tspui/rotary-printer/gerber/SmithBoard Rev B Schematic.PDF

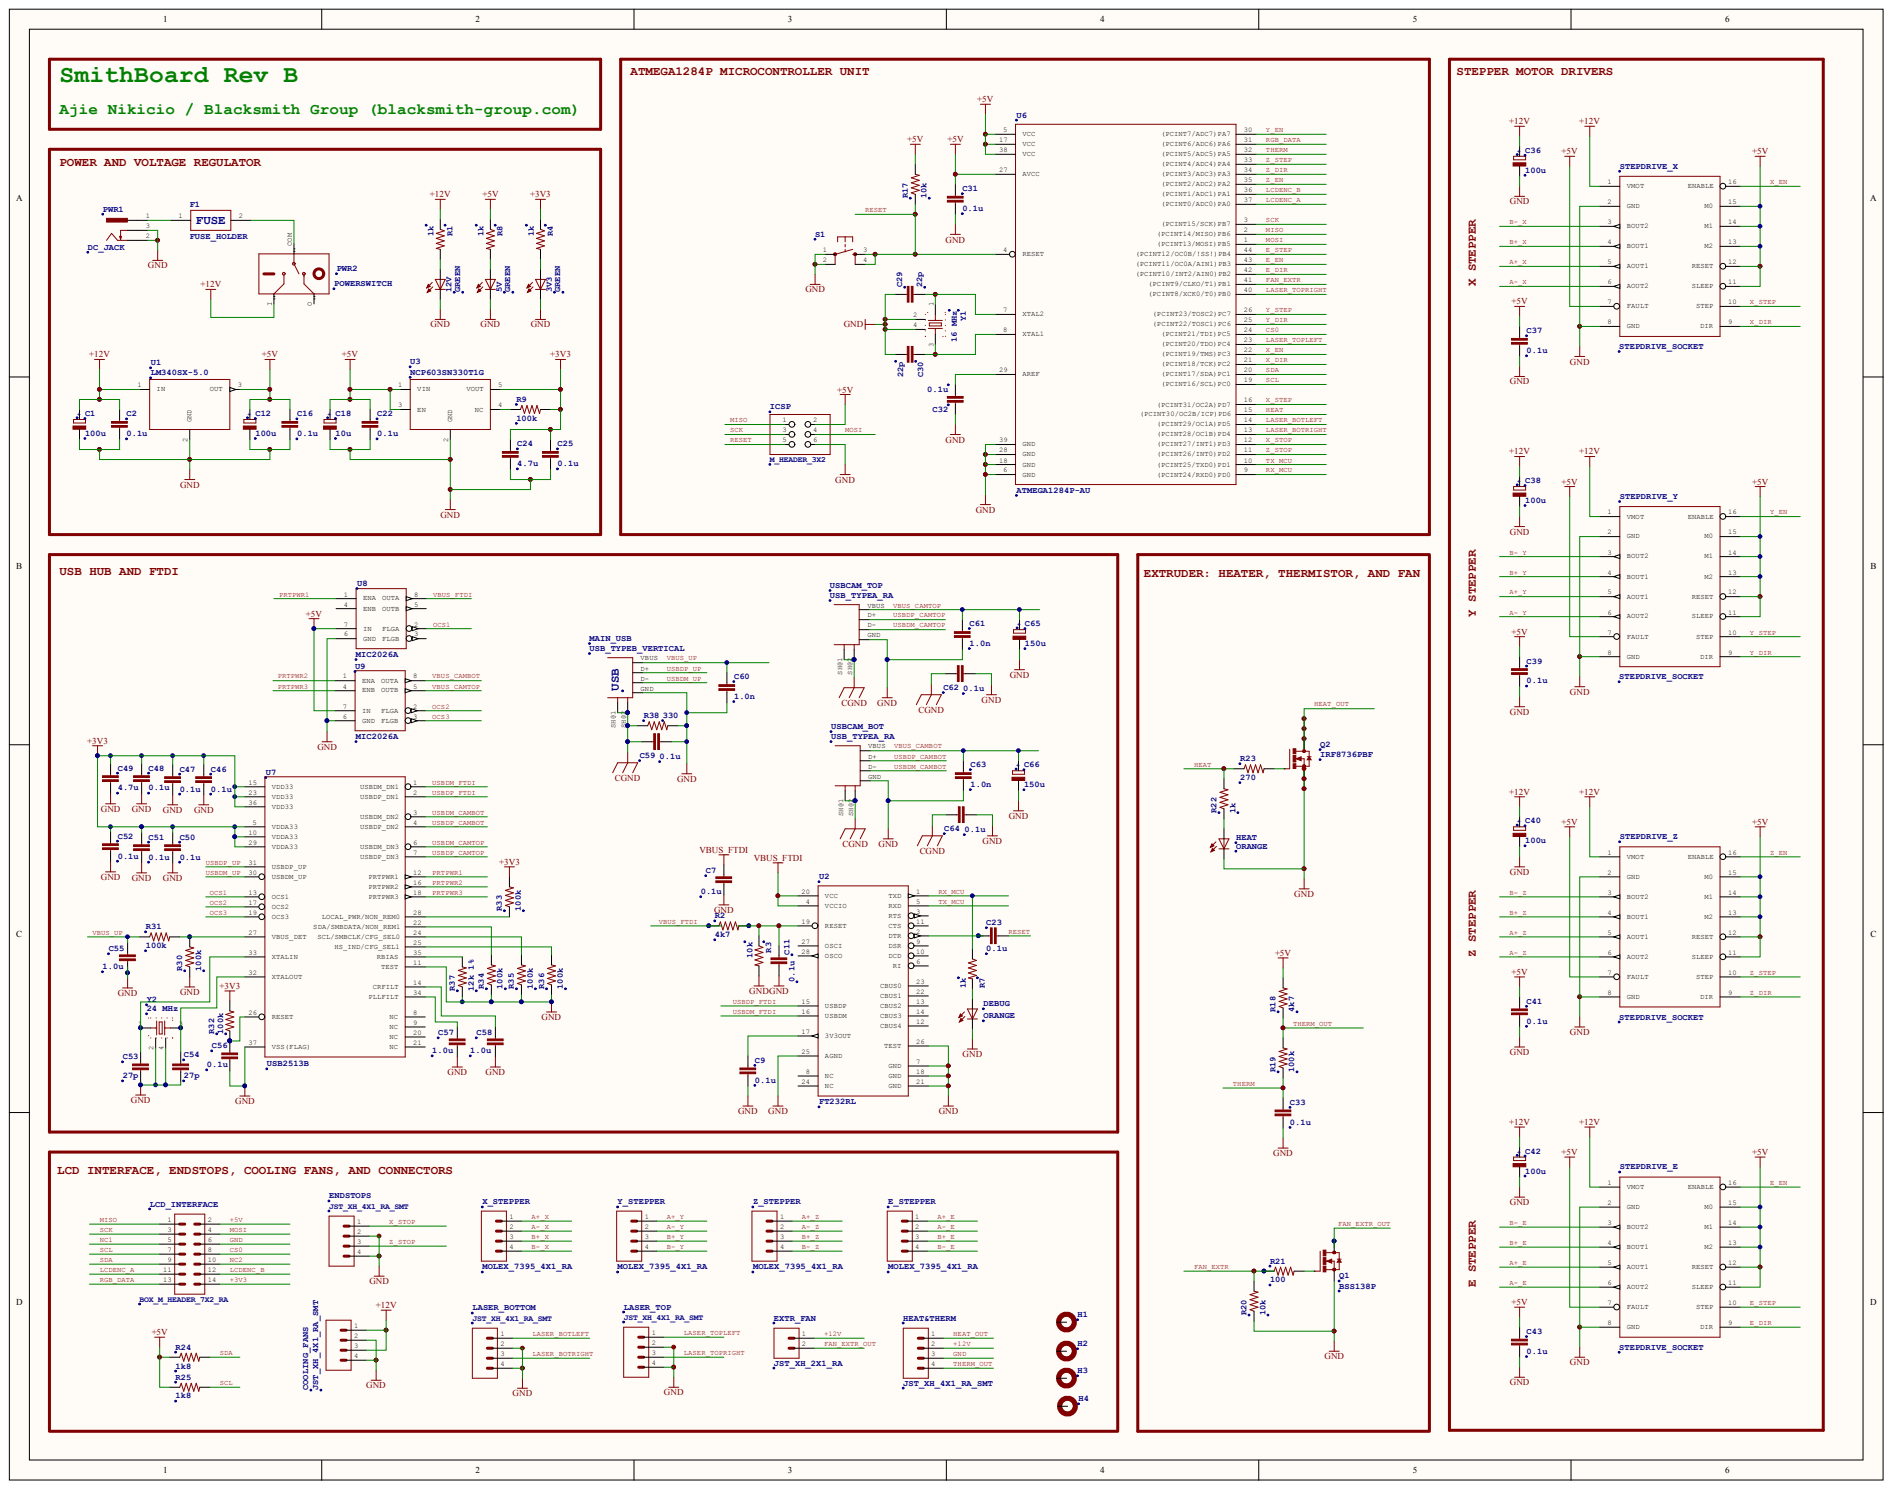
[picture p1: page 1]

STEPPER MOTOR DRIVERS X STEPPER Y STEPPER Z STEPPER E STEPPER

Ajie Nikicio / Blacksmith Group (blacksmith-group.com)

POWER AND VOLTAGE REGULATOR

LCD INTERFACE, ENDSTOPS, COOLING FANS, AND CONNECTORS

FAN_EXTR_OUT | 1234 +12V
