tspui/rotary-printer/gerber/SmithBoard Rev B PCB Layout.PDF

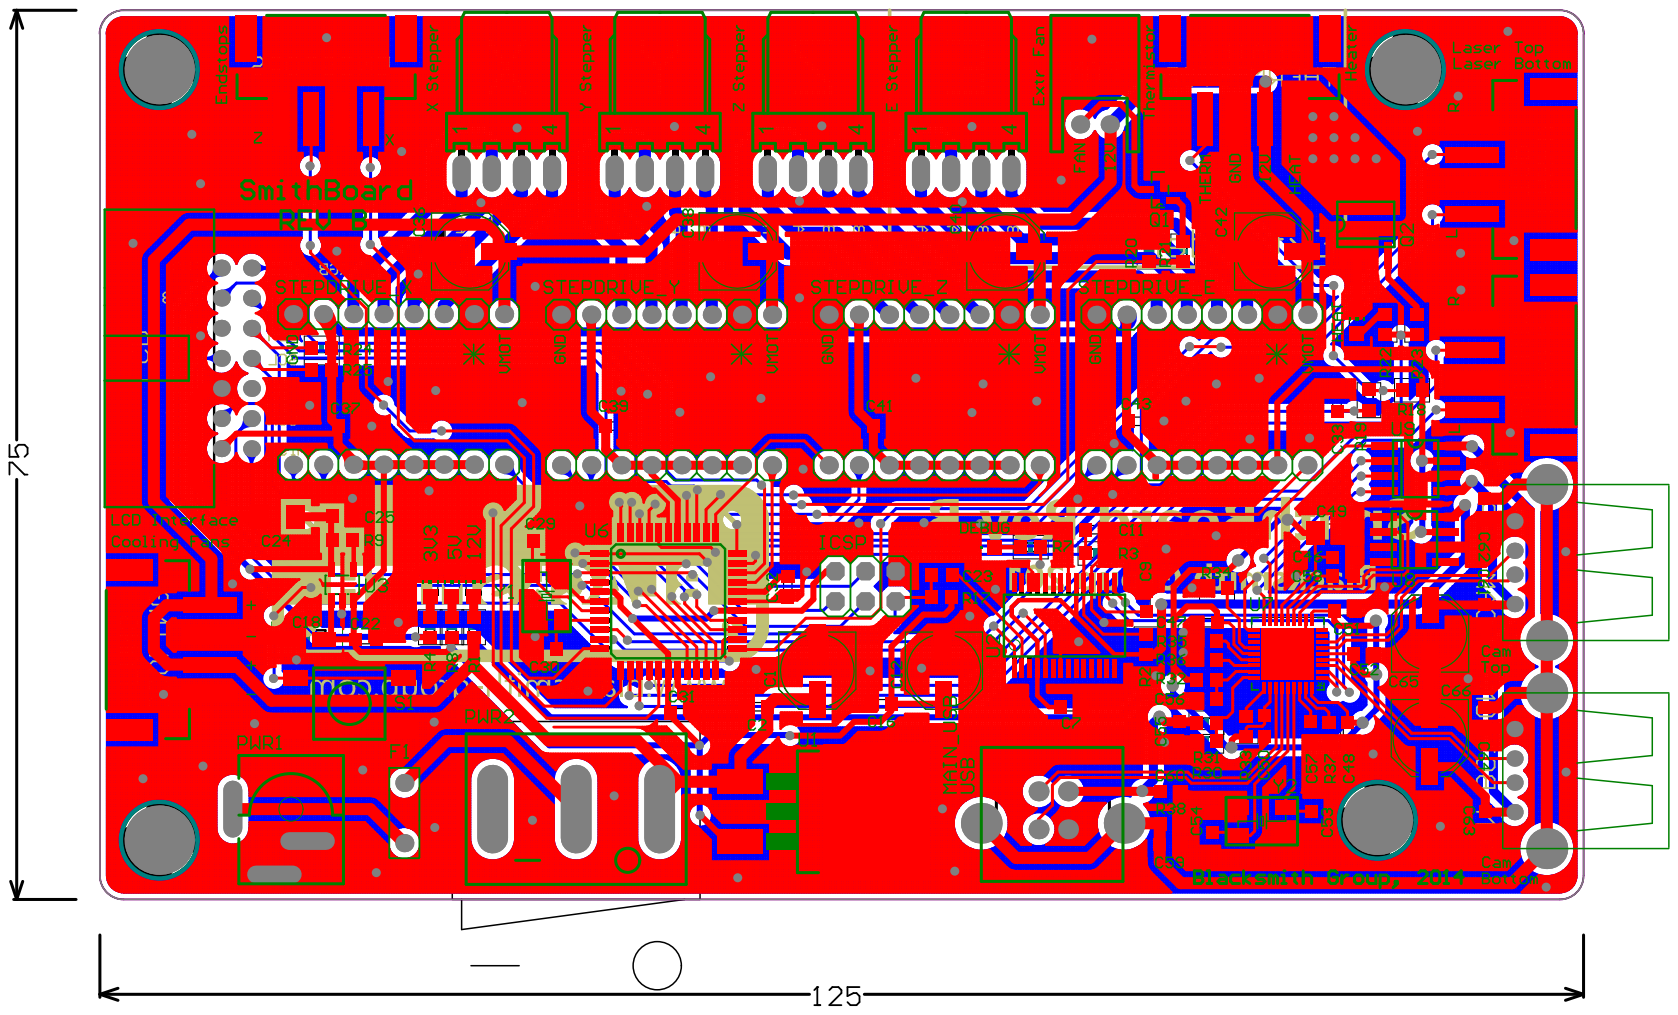
[picture p2: page 1]
