tspui/rotary-printer/marlin/Configuration.h

#define CONFIGURATION_H
#define USE_THERMISTOR 0
#define USE_LCD 0
#define USE_LED_STRIP 0
#define STRING_VERSION_CONFIG_H __DATE__ " " __TIME__ // build date and time
#define STRING_CONFIG_H_AUTHOR "(none, default config)" // Who made the changes.
#define SERIAL_PORT 0
#define BAUDRATE 250000
#define MOTHERBOARD 64
#define EXTRUDERS 1
#ifndef ROMSCRAJ_3DP
#define ROMSCRAJ_3DP_PORTABEE_V1
#endif
#define POWER_SUPPLY 1
#define TEMP_SENSOR_0 1
#define TEMP_SENSOR_1 0
#define TEMP_SENSOR_2 0
#define TEMP_SENSOR_BED 0
#define MAX_REDUNDANT_TEMP_SENSOR_DIFF 10
#define TEMP_RESIDENCY_TIME 10  // (seconds)
#define TEMP_HYSTERESIS 3       // (degC) range of +/- temperatures considered "close" to the target one
#define TEMP_WINDOW     1       // (degC) Window around target to start the residency timer x degC early.
#define HEATER_0_MINTEMP 5
#define HEATER_1_MINTEMP 5
#define HEATER_2_MINTEMP 5
#define BED_MINTEMP 5
#define HEATER_0_MAXTEMP 275
#define HEATER_1_MAXTEMP 275
#define HEATER_2_MAXTEMP 275
#define BED_MAXTEMP 150
#define PIDTEMP
#define BANG_MAX 255 // limits current to nozzle while in bang-bang mode; 255=full current
#define PID_MAX 255 // limits current to nozzle while PID is active (see PID_FUNCTIONAL_RANGE below); 255=full current
  #define PID_FUNCTIONAL_RANGE 10 // If the temperature difference between the target temperature and the actual temperature
  #define PID_INTEGRAL_DRIVE_MAX 255  //limit for the integral term
  #define K1 0.95 //smoothing factor within the PID
  #define PID_dT ((16.0 * 8.0)/(F_CPU / 64.0 / 256.0)) //sampling period of the temperature routine
    #define  DEFAULT_Kp 22.2
    #define  DEFAULT_Ki 1.08
    #define  DEFAULT_Kd 114
#define PIDTEMPBED
#define MAX_BED_POWER 255 // limits duty cycle to bed; 255=full current
    #define  DEFAULT_bedKp 10.00
    #define  DEFAULT_bedKi .023
    #define  DEFAULT_bedKd 305.4
#define PREVENT_DANGEROUS_EXTRUDE
#define PREVENT_LENGTHY_EXTRUDE
#define EXTRUDE_MINTEMP 160
#define EXTRUDE_MAXLENGTH (X_MAX_LENGTH+Y_MAX_LENGTH) //prevent extrusion of very large distances.
#define ENDSTOPPULLUPS // Comment this out (using // at the start of the line) to disable the endstop pullup resistors
  #define ENDSTOPPULLUP_XMAX
  #define ENDSTOPPULLUP_YMAX
  #define ENDSTOPPULLUP_ZMAX
  #define ENDSTOPPULLUP_XMIN
  #define ENDSTOPPULLUP_YMIN
  #define ENDSTOPPULLUP_ZMIN
const bool X_MIN_ENDSTOP_INVERTING = true; // set to true to invert the logic of the endstop.
const bool Y_MIN_ENDSTOP_INVERTING = false; // set to true to invert the logic of the endstop.
const bool Z_MIN_ENDSTOP_INVERTING = true; // set to true to invert the logic of the endstop.
const bool X_MAX_ENDSTOP_INVERTING = true; // set to true to invert the logic of the endstop.
const bool Y_MAX_ENDSTOP_INVERTING = true; // set to true to invert the logic of the endstop.
const bool Z_MAX_ENDSTOP_INVERTING = true; // set to true to invert the logic of the endstop.
#if defined(COREXY) && !defined(DISABLE_MAX_ENDSTOPS)
  #define DISABLE_MAX_ENDSTOPS
#endif
#define X_ENABLE_ON 0
#define Y_ENABLE_ON 0
#define Z_ENABLE_ON 0
#define E_ENABLE_ON 0 // For all extruders
#define DISABLE_X false
#define DISABLE_Y false
#if defined(ROMSCRAJ_3DP_MOB_V1) || defined(ROMSCRAJ_3DP_MOB_V2)
#define DISABLE_Z false
#endif
#if defined(ROMSCRAJ_3DP_DURBIE_V2) || defined(ROMSCRAJ_3DP_PORTABEE_V1) || defined(ROMSCRAJ_3DP_PORTABEE_V2) || defined(ROMSCRAJ_3DP_PORTABEE30_V1) || defined(ROMSCRAJ_3DP_JUGNOT_V1)
#define DISABLE_Z true
#endif
#define DISABLE_E false // For all extruders
#if defined(ROMSCRAJ_3DP_PORTABEE_V1) || defined(ROMSCRAJ_3DP_PORTABEE_V2)  || defined(ROMSCRAJ_3DP_PORTABEE30_V1)
#define INVERT_X_DIR true
#endif
#if defined(ROMSCRAJ_3DP_DURBIE_V2) || defined(ROMSCRAJ_3DP_MOB_V1) || defined(ROMSCRAJ_3DP_JUGNOT_V1) || defined(ROMSCRAJ_3DP_MOB_V2)
#define INVERT_X_DIR true
#endif
#if defined(ROMSCRAJ_3DP_DURBIE_V2) || defined(ROMSCRAJ_3DP_PORTABEE_V1) || defined(ROMSCRAJ_3DP_PORTABEE_V2) || defined(ROMSCRAJ_3DP_JUGNOT_V1)
#define INVERT_Y_DIR false    // for Mendel set to true, for Orca set to false
#define INVERT_Z_DIR true     // for Mendel set to false, for Orca set to true
#endif
#if defined(ROMSCRAJ_3DP_DURBIE_V2) || defined(ROMSCRAJ_3DP_PORTABEE_V1) || defined(ROMSCRAJ_3DP_JUGNOT_V1)
#define INVERT_E0_DIR false
#endif
#if defined(ROMSCRAJ_3DP_MOB_V1)  || defined(ROMSCRAJ_3DP_PORTABEE30_V1) || defined(ROMSCRAJ_3DP_PORTABEE_V2) || defined(ROMSCRAJ_3DP_MOB_V2)
#define INVERT_E0_DIR true
#endif
#define INVERT_E1_DIR true   // for direct drive extruder v9 set to true, for geared extruder set to false
#define INVERT_E2_DIR true   // for direct drive extruder v9 set to true, for geared extruder set to false
#define X_HOME_DIR -1
#define Y_HOME_DIR -1
#define Z_HOME_DIR -1
#define min_software_endstops true // If true, axis won't move to coordinates less than HOME_POS.
#define max_software_endstops true  // If true, axis won't move to coordinates greater than the defined lengths below.
#define X_MAX_POS 120	// 120mm max (changed 21 Jan 2015)
#define X_MIN_POS 0
#define Y_MAX_POS 1000000
#define Y_MIN_POS -1000000
#define Z_MAX_POS 220	// 160mm max (changed 21 Jan 2015), 23 Jan 2015 change to 112, 6 Jun 2015 change to 220
#define Z_MIN_POS 0
#define Z_MIN_POS 0
#define X_MAX_LENGTH (X_MAX_POS - X_MIN_POS)
#define Y_MAX_LENGTH (Y_MAX_POS - Y_MIN_POS)
#define Z_MAX_LENGTH (Z_MAX_POS - Z_MIN_POS)
#define MANUAL_HOME_POSITIONS  // If defined, MANUAL_*_HOME_POS below will be used
#define MANUAL_X_HOME_POS 0
#define MANUAL_Y_HOME_POS 0
#define MANUAL_Z_HOME_POS 0
#define NUM_AXIS 4 // The axis order in all axis related arrays is X, Y, Z, E
#define HOMING_FEEDRATE {50*60, 50*60, 25*60, 0}  // set the homing speeds (mm/min)
#define DEFAULT_AXIS_STEPS_PER_UNIT   {80,80,400,96}  // 1/16 micro stepping
#define DEFAULT_MAX_FEEDRATE          {500, 500, 50, 25}    // (mm/sec)
#define DEFAULT_MAX_ACCELERATION      {9000,9000,100,10000}    // X, Y, Z, E maximum start speed for accelerated moves. E default values are good for skeinforge 40+, for older versions raise them a lot.
#define DEFAULT_ACCELERATION          3000    // X, Y, Z and E max acceleration in mm/s^2 for printing moves
#define DEFAULT_RETRACT_ACCELERATION  3000   // X, Y, Z and E max acceleration in mm/s^2 for retracts
#define DEFAULT_XYJERK                20.0    // (mm/sec)
#define DEFAULT_ZJERK                 0.4     // (mm/sec)
#define DEFAULT_EJERK                 5.0    // (mm/sec)
#define EEPROM_CHITCHAT
#define PLA_PREHEAT_HOTEND_TEMP 180
#define PLA_PREHEAT_HPB_TEMP 70
#define PLA_PREHEAT_FAN_SPEED 255   // Insert Value between 0 and 255
#define ABS_PREHEAT_HOTEND_TEMP 240
#define ABS_PREHEAT_HPB_TEMP 100
#define ABS_PREHEAT_FAN_SPEED 255   // Insert Value between 0 and 255
#if USE_LCD
#define LCD_I2C_PANELOLU2
#endif
#ifdef LCD_I2C_PANELOLU2
  #define LCD_I2C_TYPE_MCP23017
  #define LCD_I2C_ADDRESS 0x20 // I2C Address of the port expander
  #define LCD_USE_I2C_BUZZER //comment out to disable buzzer on LCD
  #define NEWPANEL
  #define ULTIPANEL
#endif
#ifdef ULTIPANEL
  #define SDSUPPORT
  #define ULTRA_LCD
    #define LCD_WIDTH 20
    #define LCD_HEIGHT 4
#else //no panel but just lcd
  #ifdef ULTRA_LCD
    #define LCD_WIDTH 16
    #define LCD_HEIGHT 2
  #endif
#endif
#define SOFT_PWM_SCALE 0
#include "Configuration_adv.h"
#include "thermistortables.h"
